dbaudin1/Kicad_Libraries_Perso/3D/IDEFX/Body.step

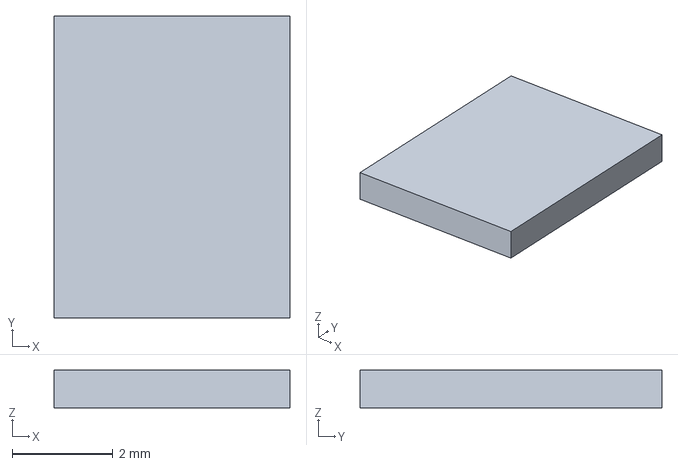
[picture p1: CAD file, 2022-09-28]
3D/IDEFX/Body.step
4.68 x 6.00 x 0.75 mm
