dbaudin1/Kicad_Libraries_Perso/3D/SDD/Body.step

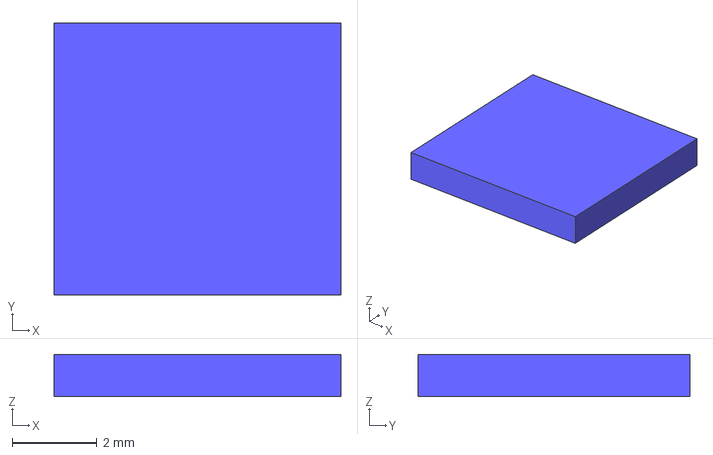
[picture p2: CAD file, 2022-09-28]
3D/SDD/Body.step
6.78 x 6.43 x 1.00 mm
