dbaudin1/Kicad_Libraries_Perso/3D/CLP-109-02-F-DH.stp

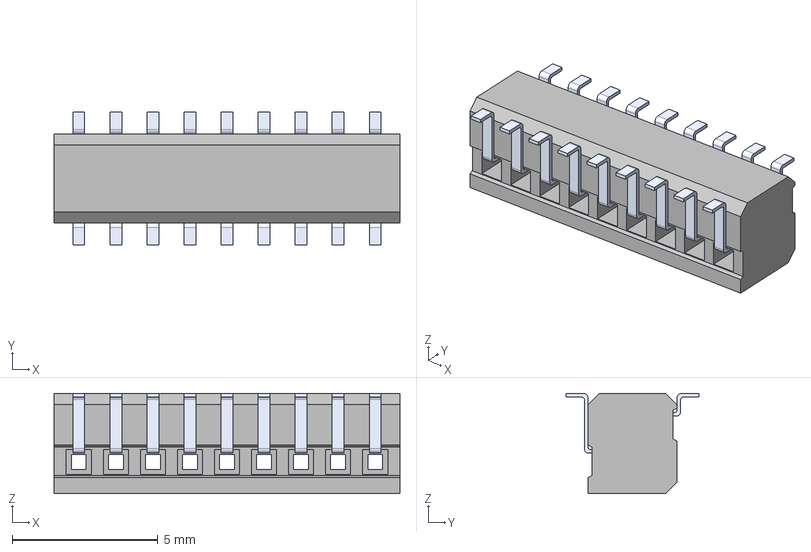
[picture p3: CAD file, 2024-11-20]
3D/CLP-109-02-F-DH.stp
11.9 x 4.57 x 3.43 mm
C-70-05-109_Pin_dh
C-70-04-109_Pin_2_dh
CLP-109-2-F-DH_terminal
