dbaudin1/Kicad_Libraries_Perso/3D/IDEFX/IDEFX.FCStd

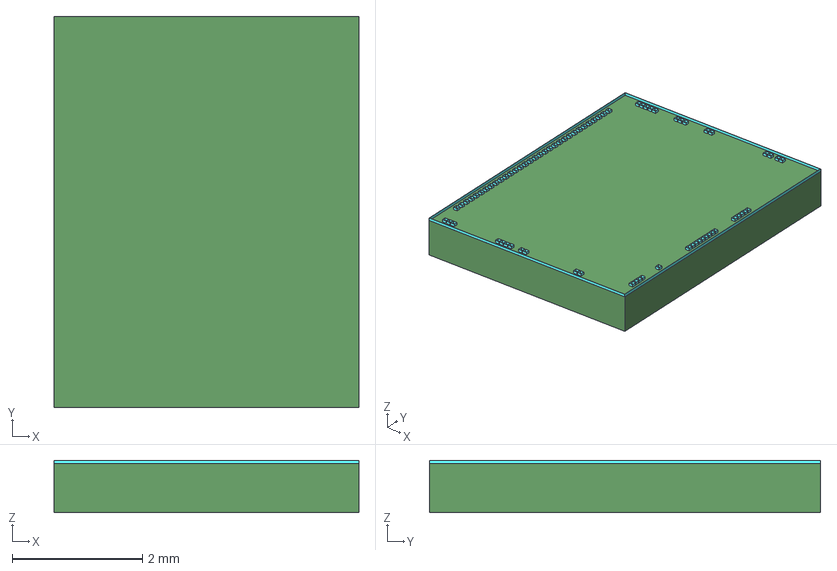
[picture p4: CAD file, 2022-09-28]
3D/IDEFX/IDEFX.FCStd
4.68 x 6.00 x 0.8 mm
