dbaudin1/Kicad_Libraries_Perso/3D/IDEFX/Extrude.step

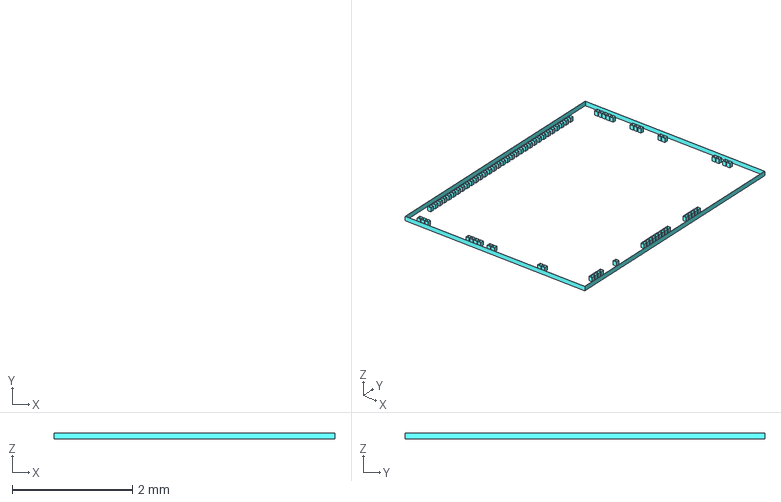
[picture p5: CAD file, 2022-09-28]
3D/IDEFX/Extrude.step
4.68 x 6.00 x 0.1 mm
