dbaudin1/Kicad_Libraries_Perso/3D/Fischer_DBPE_105_A069-130.stp

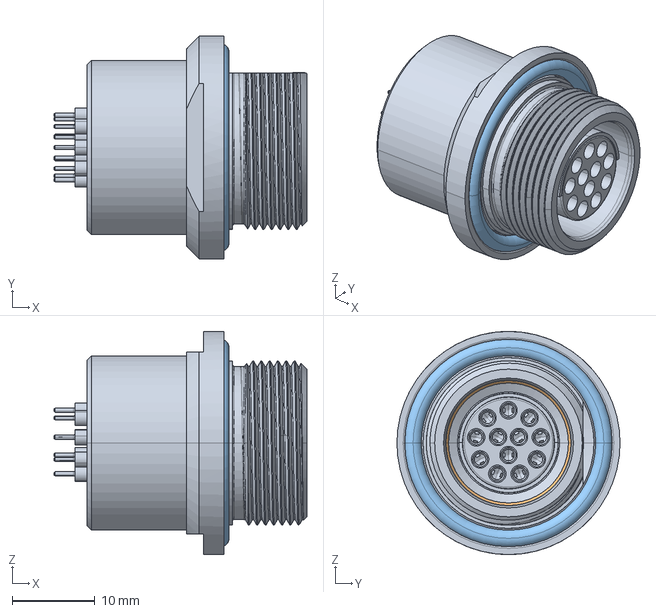
[picture p6: CAD file, 2024-11-20]
3D/Fischer_DBPE_105_A069-130.stp
30.5 x 26.9 x 26.9 mm
