dbaudin1/Kicad_Libraries_Perso/3D/IND_IHLP-4040DZ_VIS.step

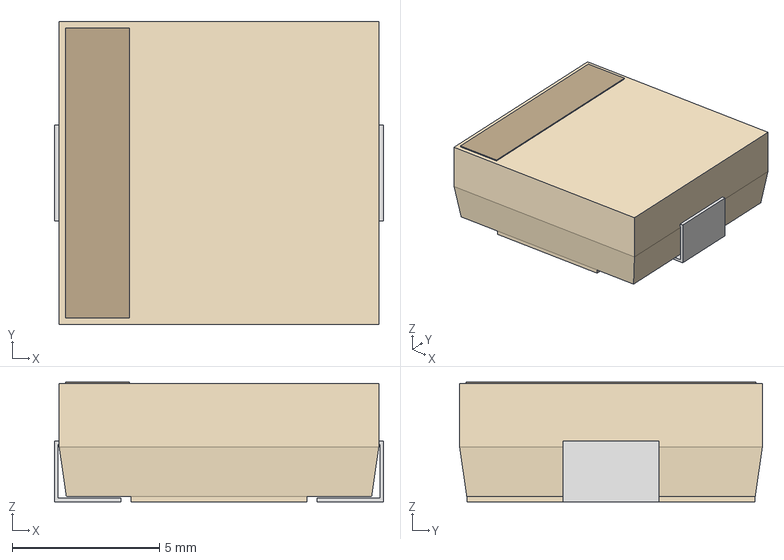
[picture p7: CAD file, 2024-11-20]
3D/IND_IHLP-4040DZ_VIS.step
11.2 x 10.3 x 4.06 mm
