dbaudin1/Kicad_Libraries_Perso/3D/CLP-118-02-F-DH.stp

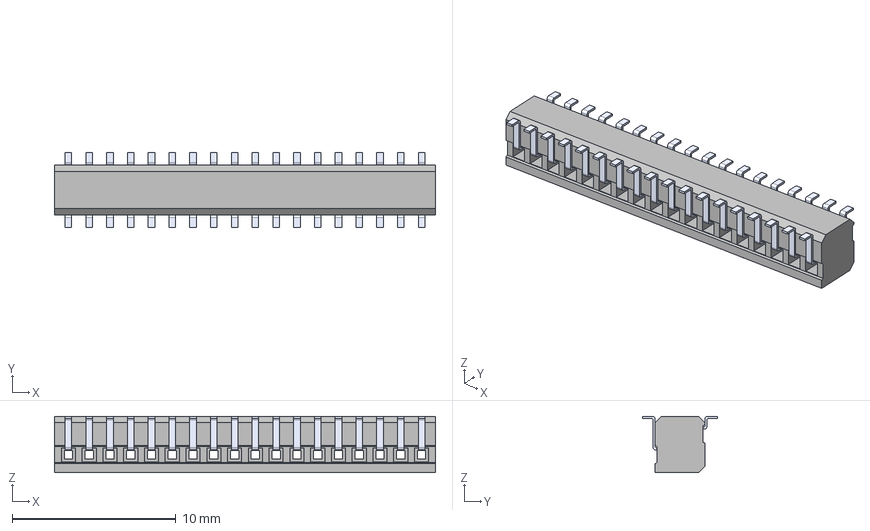
[picture p8: CAD file, 2024-11-20]
3D/CLP-118-02-F-DH.stp
23.3 x 4.57 x 3.43 mm
C-70-05-118_Pin_dh
C-70-04-118_Pin_2_dh
CLP-118-2-F-DH_terminal
