dbaudin1/Kicad_Libraries_Perso/3D/mill-max-0921-5-15-20-77-14-11-0.step

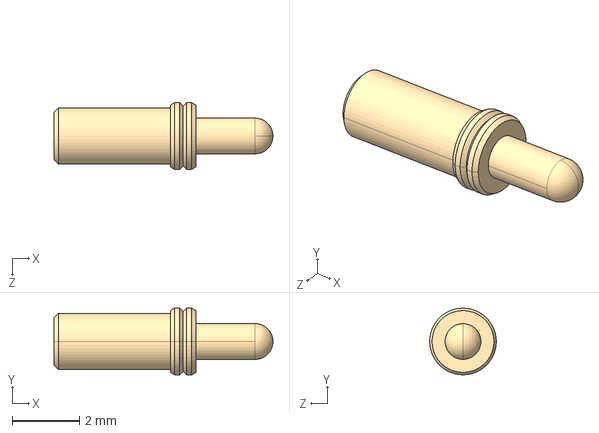
[picture p9: CAD file, 2024-11-20]
3D/mill-max-0921-5-15-20-77-14-11-0.step
6.50 x 1.98 x 1.98 mm
