dbaudin1/Kicad_Libraries_Perso/3D/ezg_00_302_cln.stp

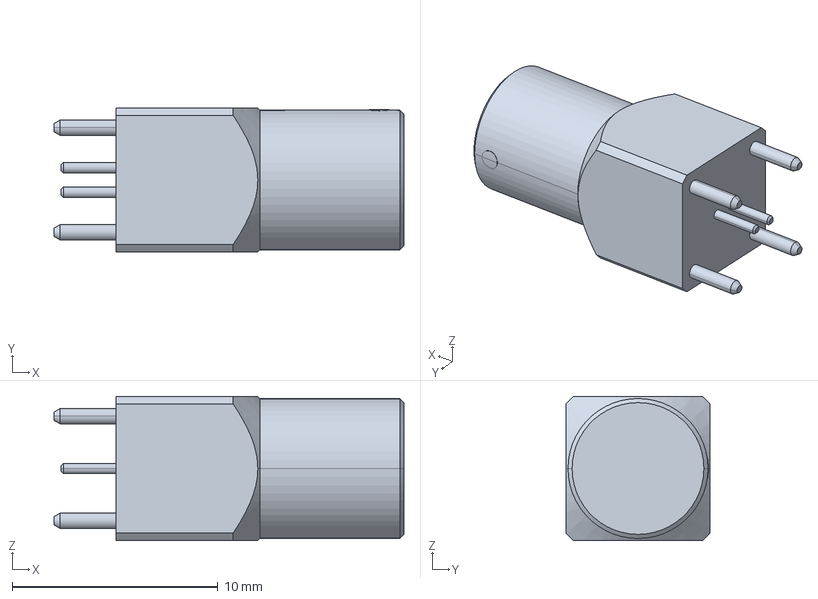
[picture p10: CAD file, 2024-11-20]
3D/ezg_00_302_cln.stp
17.0 x 7.00 x 7.00 mm
