dbaudin1/Kicad_Libraries_Perso/3D/901-144.stp

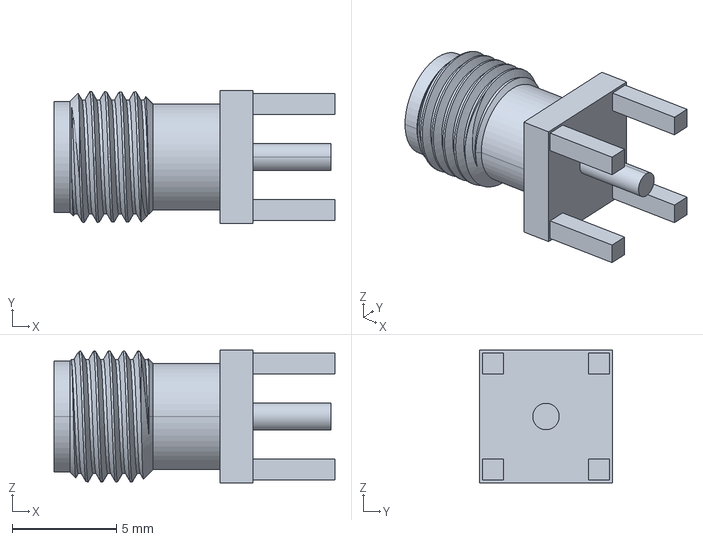
[picture p11: CAD file, 2024-11-20]
3D/901-144.stp
13.5 x 6.35 x 6.35 mm
