dbaudin1/Kicad_Libraries_Perso/3D/OWB1_TOP.step

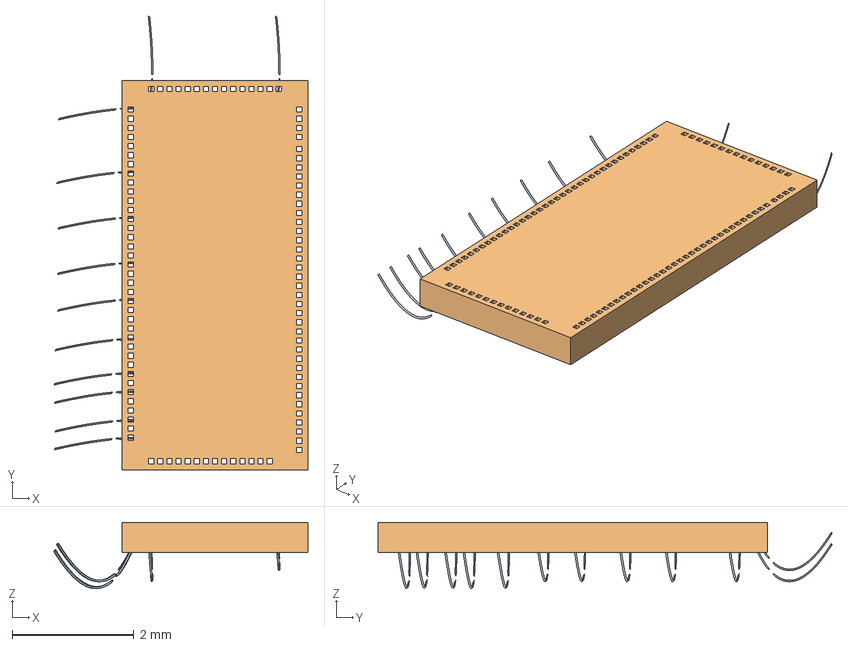
[picture p12: CAD file, 2024-11-20]
3D/OWB1_TOP.step
4.18 x 7.47 x 1.09 mm
