dbaudin1/Kicad_Libraries_Perso/3D/311-xx-102-41-001000.STEP

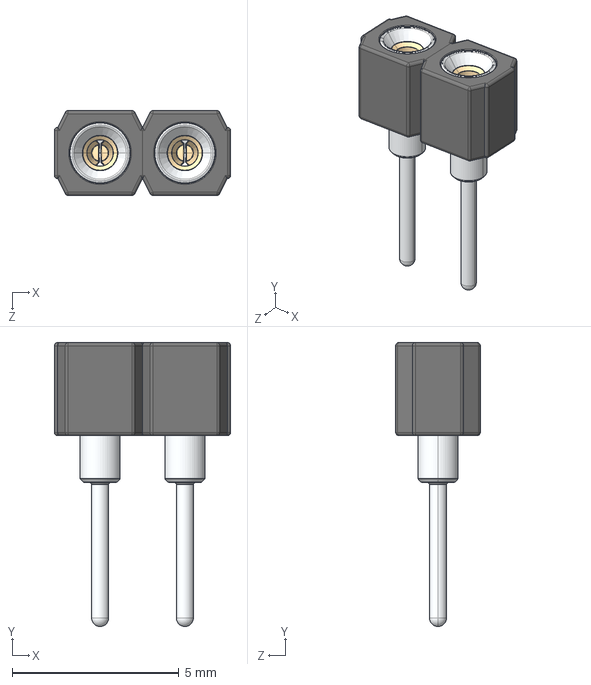
[picture p13: CAD file, 2024-11-20]
3D/311-xx-102-41-001000.STEP
5.28 x 8.51 x 2.54 mm
311-xx-101-41-001000 x 2
