dbaudin1/Kicad_Libraries_Perso/3D/SMA-J-P-H-ST-EM1.stp

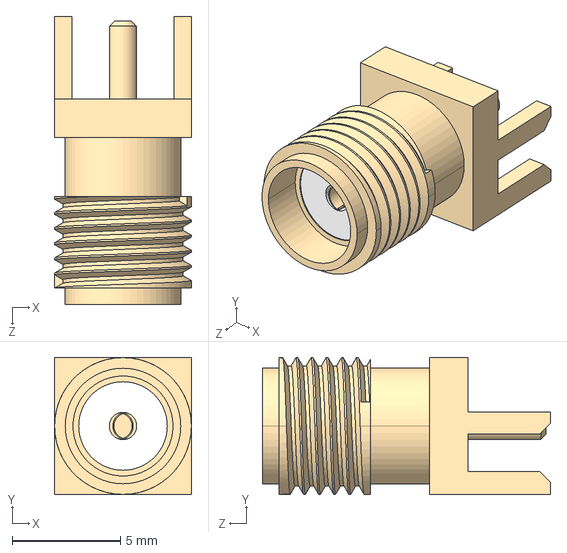
[picture p14: CAD file, 2024-11-20]
3D/SMA-J-P-H-ST-EM1.stp
6.35 x 6.35 x 13.3 mm
