dbaudin1/Kicad_Libraries_Perso/3D/DCCM37SCBRP.stp

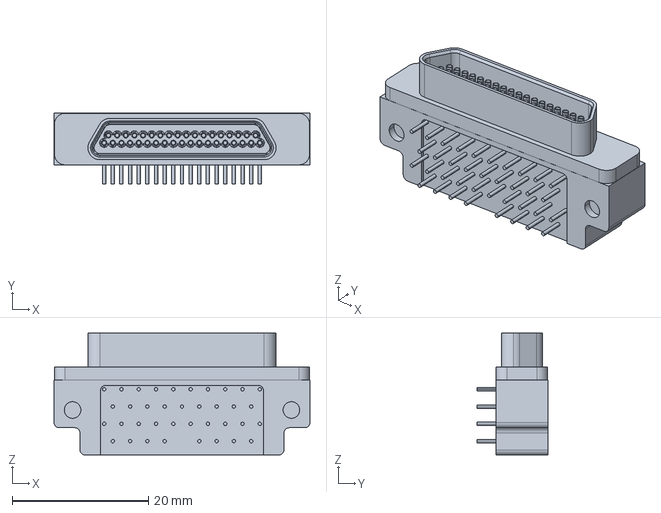
[picture p15: CAD file, 2022-09-28]
3D/DCCM37SCBRP.stp
37.6 x 10.4 x 17.9 mm
