dbaudin1/Kicad_Libraries_Perso/3D/IDC_RightAngle_02x03.stp

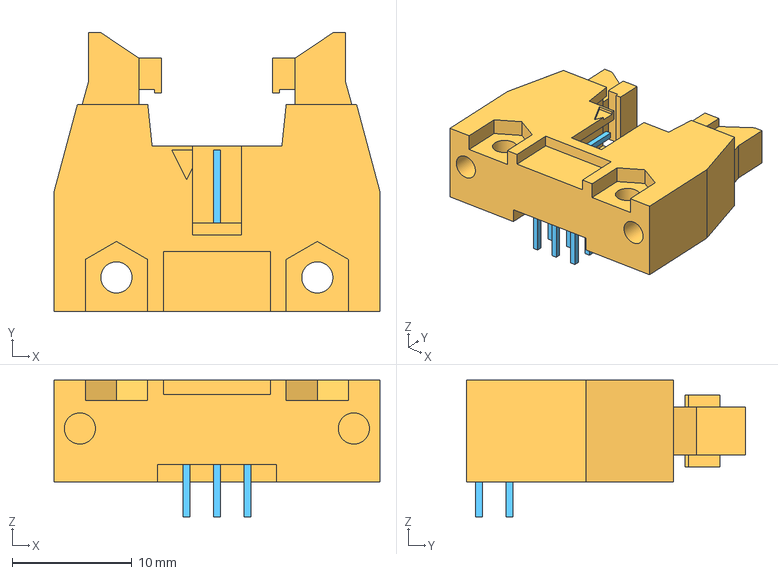
[picture p16: CAD file, 2022-09-28]
3D/IDC_RightAngle_02x03.stp
27.2 x 23.3 x 11.4 mm
