dbaudin1/Kicad_Libraries_Perso/3D/TF31-12S-0.5SH_3d_stp.stp

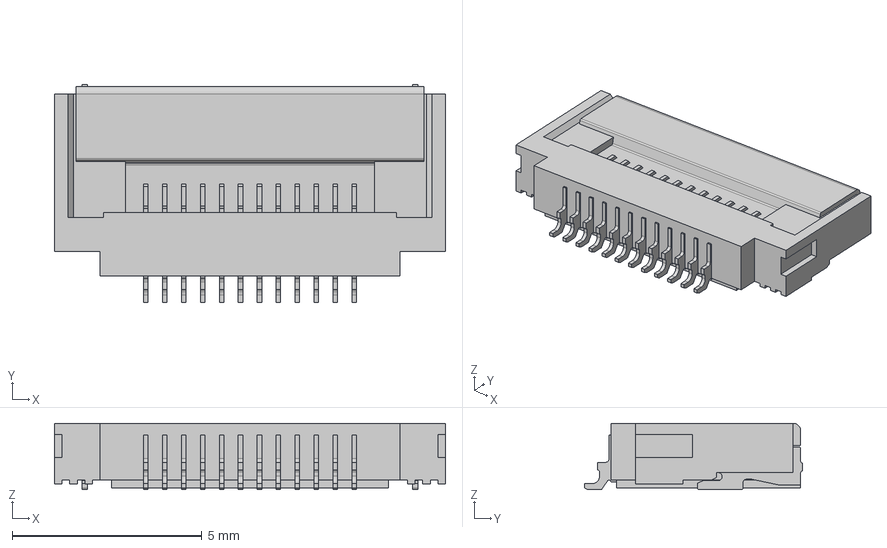
[picture p17: CAD file, 2022-09-28]
3D/TF31-12S-0.5SH_3d_stp.stp
10.3 x 5.75 x 1.75 mm
