dbaudin1/Kicad_Libraries_Perso/3D/banana_plug.STEP

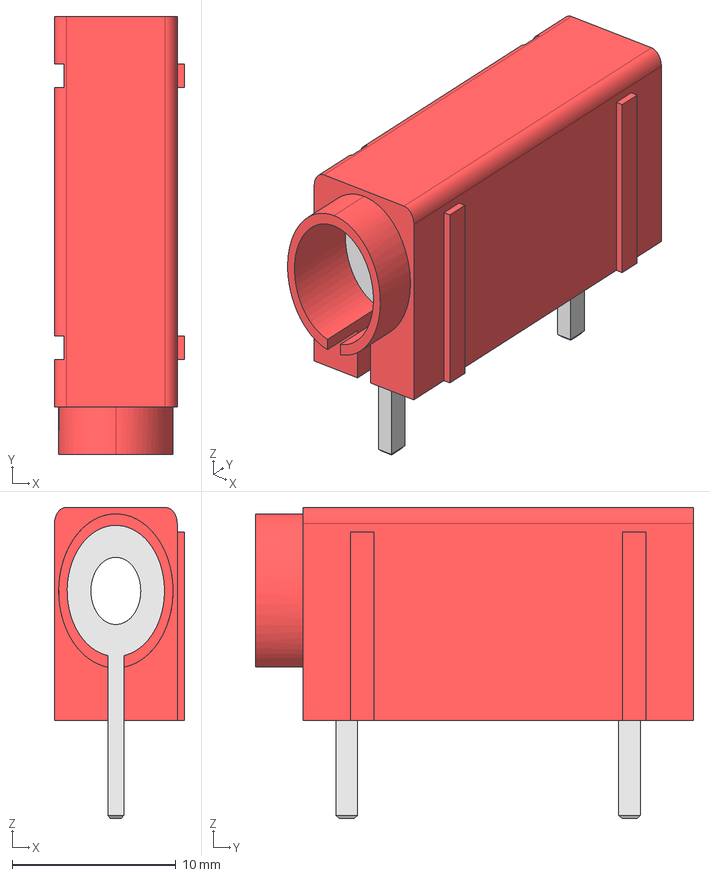
[picture p18: CAD file, 2022-09-28]
3D/banana_plug.STEP
7.95 x 26.7 x 19.0 mm
