dbaudin1/Kicad_Libraries_Perso/3D/s0921-46.stp

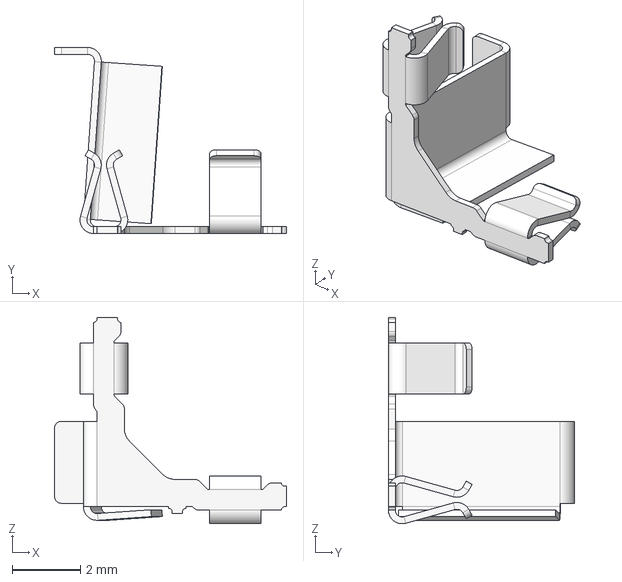
[picture p19: CAD file, 2022-09-28]
3D/s0921-46.stp
6.80 x 5.45 x 6.05 mm
