dbaudin1/Kicad_Libraries_Perso/3D/SMA_Edge.stp

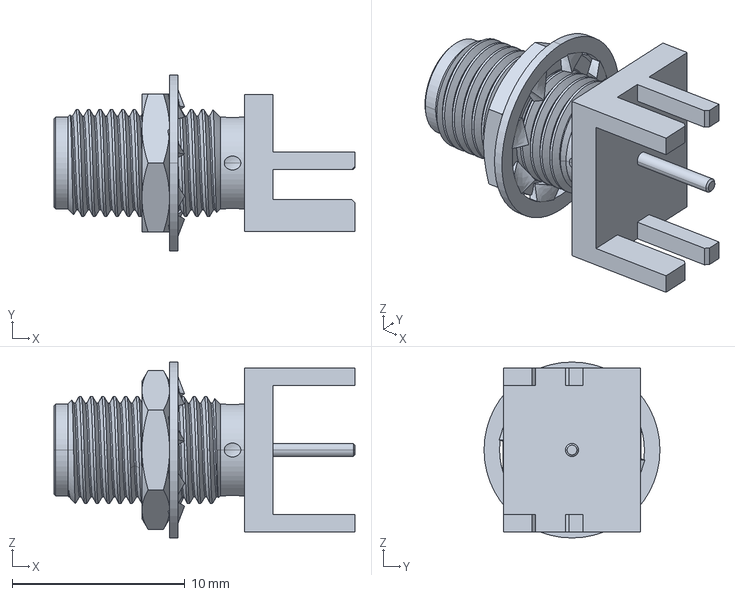
[picture p20: CAD file, 2022-09-28]
3D/SMA_Edge.stp
17.4 x 10.2 x 10.2 mm
