dbaudin1/Kicad_Libraries_Perso/3D/microD_25.stp

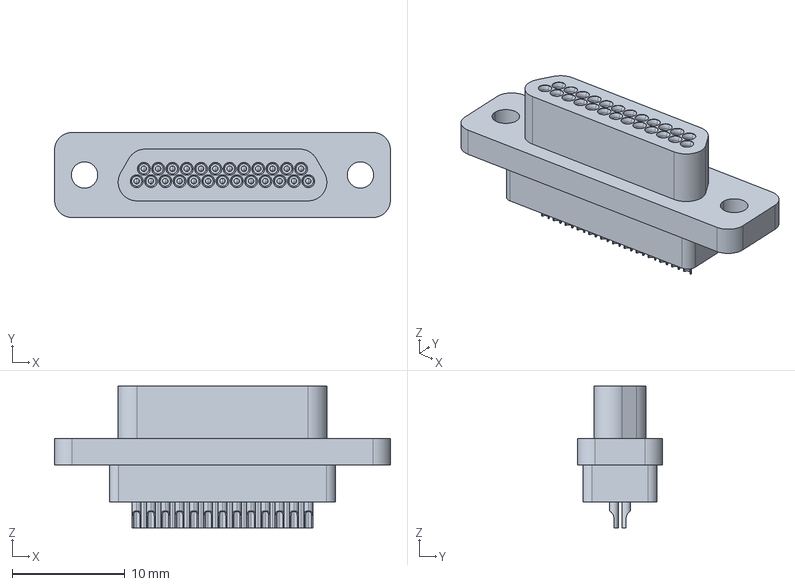
[picture p21: CAD file, 2022-09-28]
3D/microD_25.stp
29.8 x 7.57 x 12.6 mm
