dbaudin1/Kicad_Libraries_Perso/3D/s0911-46.stp

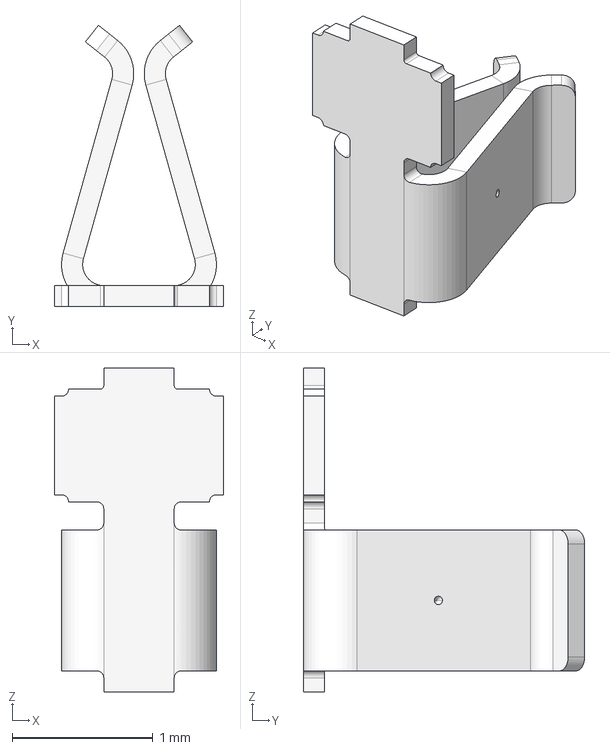
[picture p23: CAD file, 2022-09-28]
3D/s0911-46.stp
1.20 x 2.00 x 2.30 mm
