dbaudin1/Kicad_Libraries_Perso/3D/IDC_RA_02x02.stp

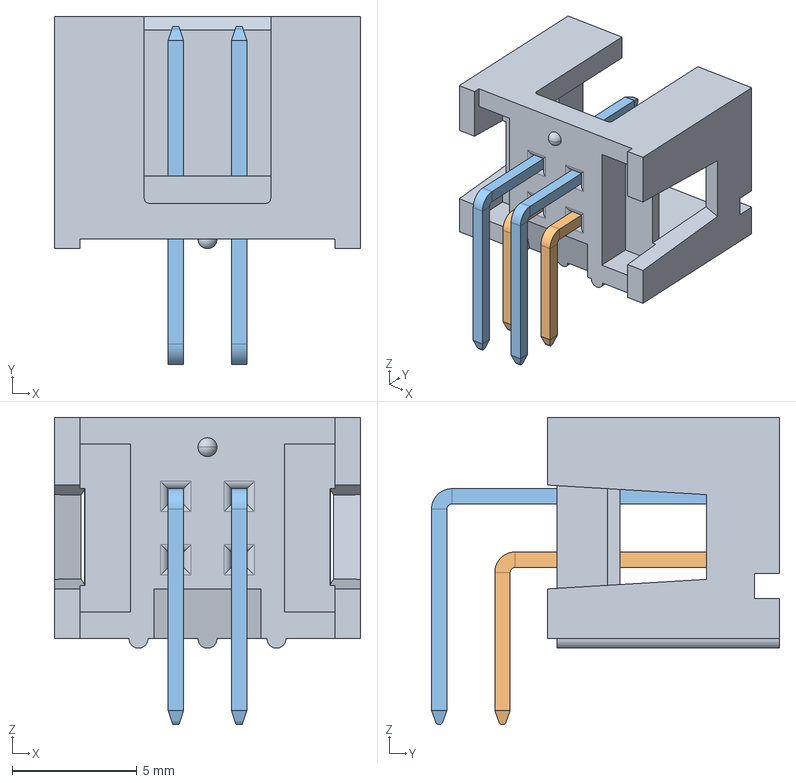
[picture p24: CAD file, 2022-09-28]
3D/IDC_RA_02x02.stp
12.3 x 14.0 x 12.3 mm
71965_Y04
71953_X03 x 2
71953_X04 x 2
