dbaudin1/Kicad_Libraries_Perso/3D/DCCM37PCBRP.stp

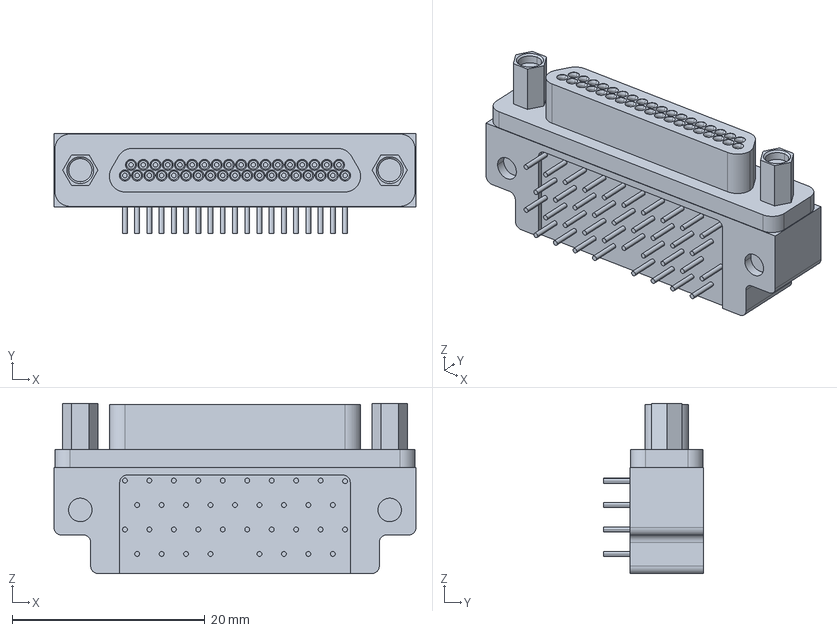
[picture p25: CAD file, 2022-09-28]
3D/DCCM37PCBRP.stp
37.6 x 10.4 x 17.7 mm
