dbaudin1/Kicad_Libraries_Perso/3D/Switch_090320102.stp

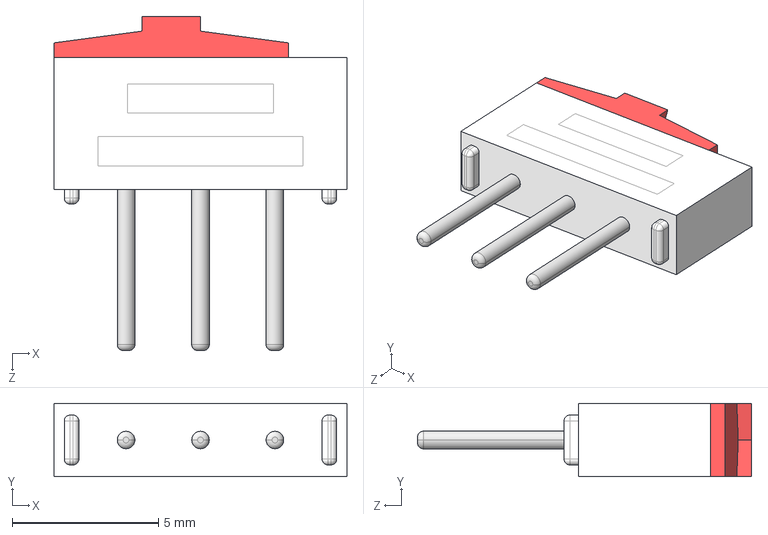
[picture p26: CAD file, 2022-09-28]
3D/Switch_090320102.stp
10.0 x 2.50 x 11.4 mm
