dbaudin1/Kicad_Libraries_Perso/3D/SMA_RA_SurfaceMount.stp

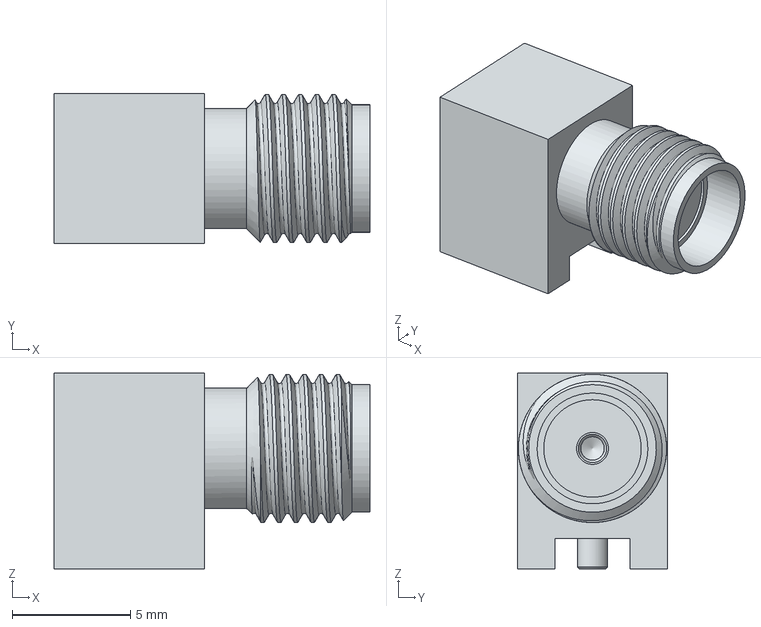
[picture p27: CAD file, 2021-06-25]
3D/SMA_RA_SurfaceMount.stp
13.3 x 6.35 x 8.26 mm
