dbaudin1/Kicad_Libraries_Perso/3D/Toogle_Switch.stp

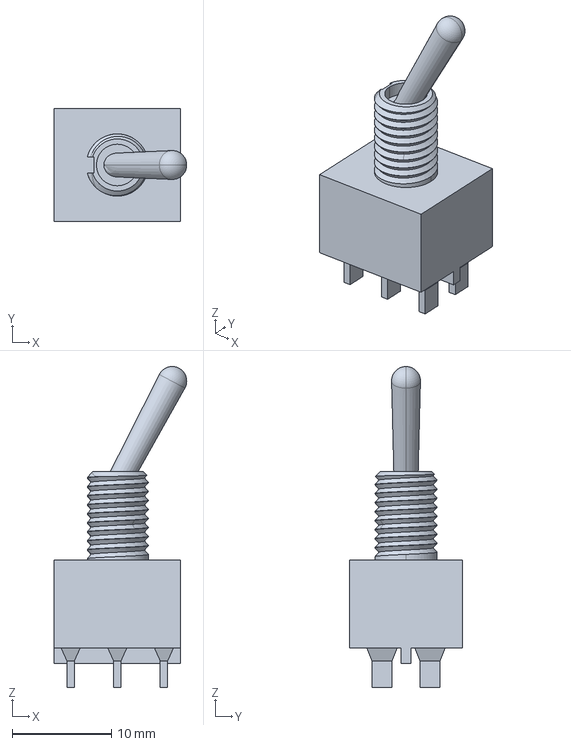
[picture p28: CAD file, 2021-06-25]
3D/Toogle_Switch.stp
13.3 x 11.4 x 32.3 mm
