dbaudin1/Kicad_Libraries_Perso/3D/c-282834-3-c-3d.stp

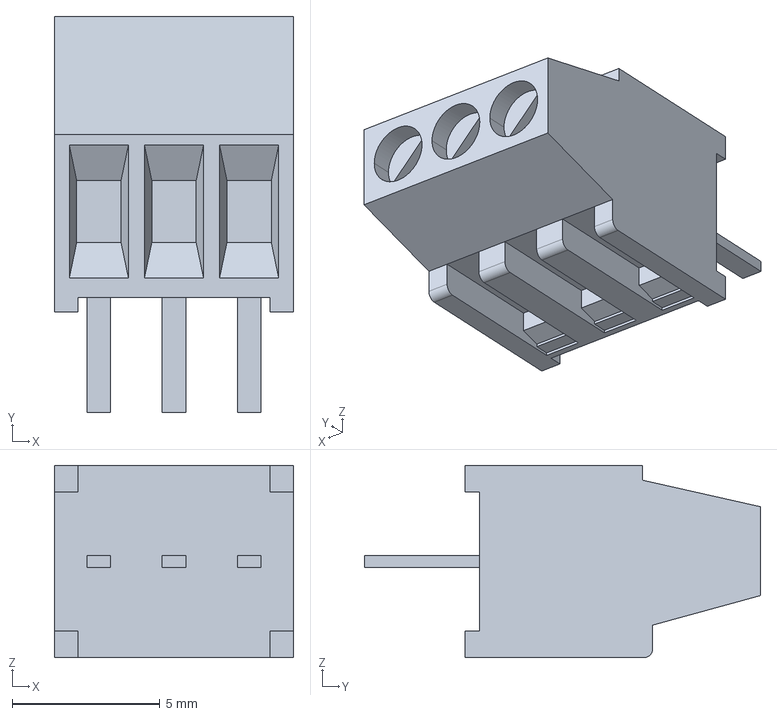
[picture p29: CAD file, 2021-04-16]
3D/c-282834-3-c-3d.stp
8.08 x 13.4 x 6.50 mm
