dbaudin1/Kicad_Libraries_Perso/3D/LCC8_1P5X3P2_STM.step

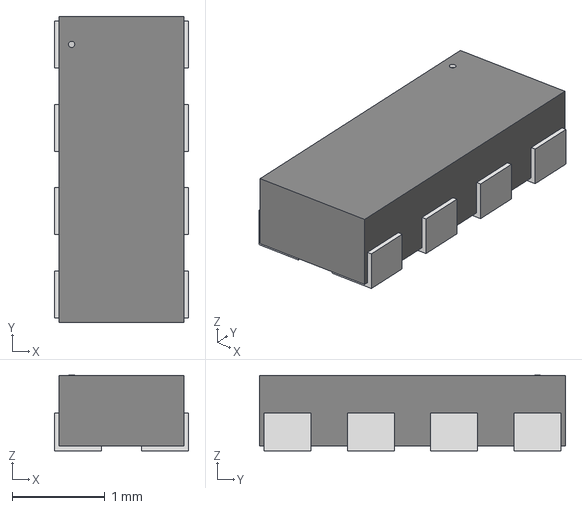
[picture p30: CAD file, 2021-04-16]
3D/LCC8_1P5X3P2_STM.step
1.45 x 3.30 x 0.815 mm
