dbaudin1/Kicad_Libraries_Perso/3D/QFN-44_MCH.step

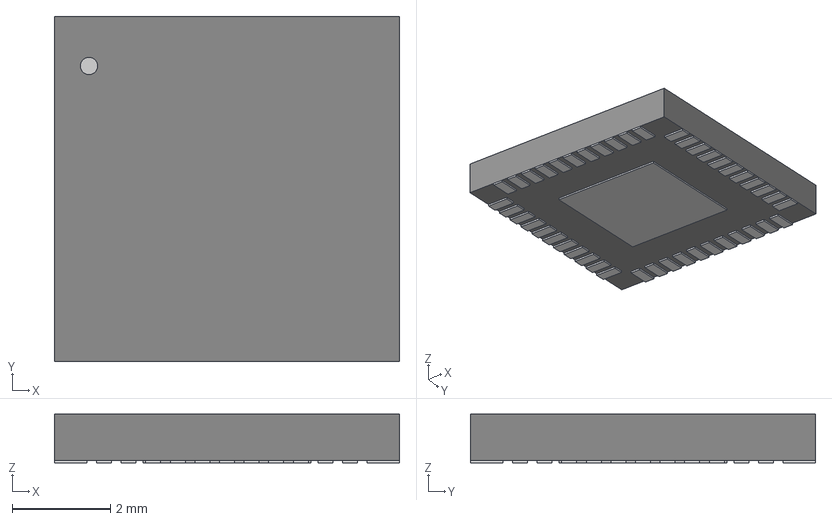
[picture p31: CAD file, 2021-04-16]
3D/QFN-44_MCH.step
7.01 x 7.01 x 0.993 mm
