dbaudin1/Kicad_Libraries_Perso/3D/RE_24_ADI.step

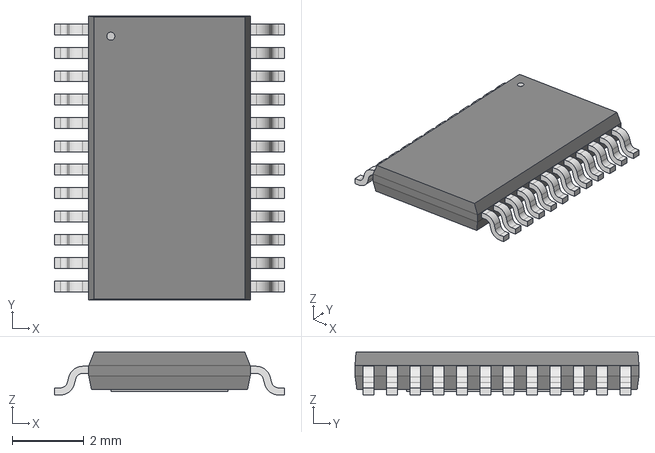
[picture p32: CAD file, 2021-04-16]
3D/RE_24_ADI.step
6.40 x 7.90 x 1.20 mm
