dbaudin1/Kicad_Libraries_Perso/3D/EPL.00.250.DTN.stp

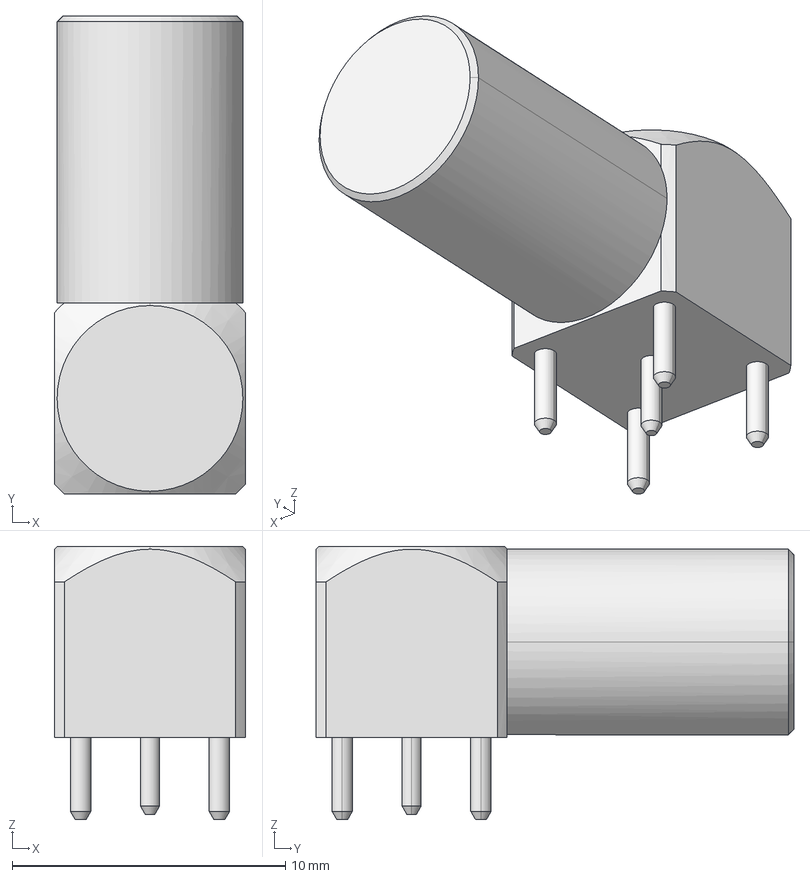
[picture p33: CAD file, 2021-04-16]
3D/EPL.00.250.DTN.stp
7.00 x 17.5 x 10.0 mm
