dbaudin1/Kicad_Libraries_Perso/3D/UM030Z1009JE.step

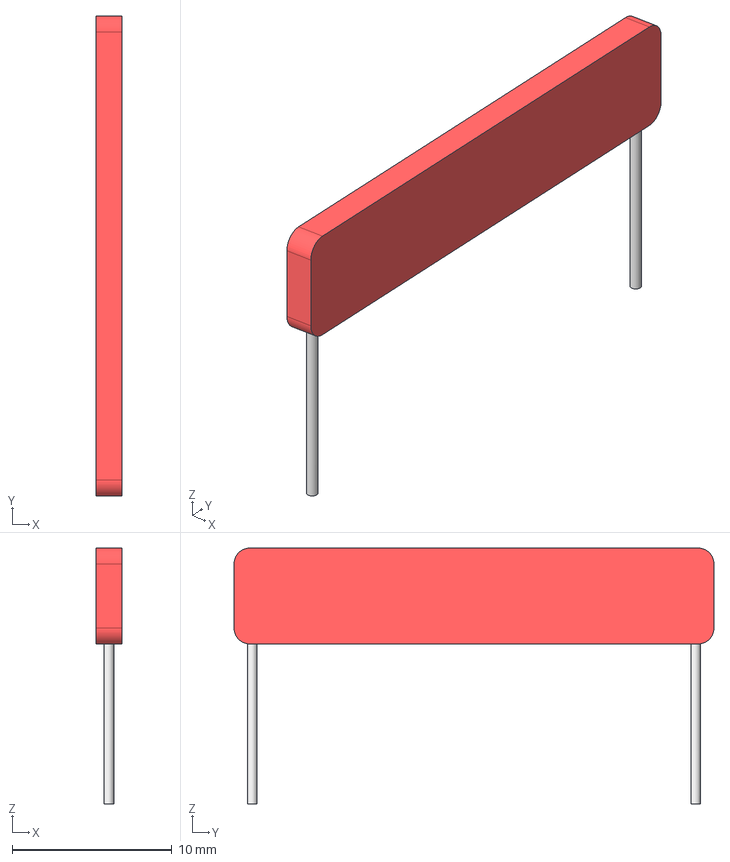
[picture p34: CAD file, 2021-04-16]
3D/UM030Z1009JE.step
1.60 x 30.0 x 16.0 mm
