dbaudin1/Kicad_Libraries_Perso/3D/RJ45_RA.STEP

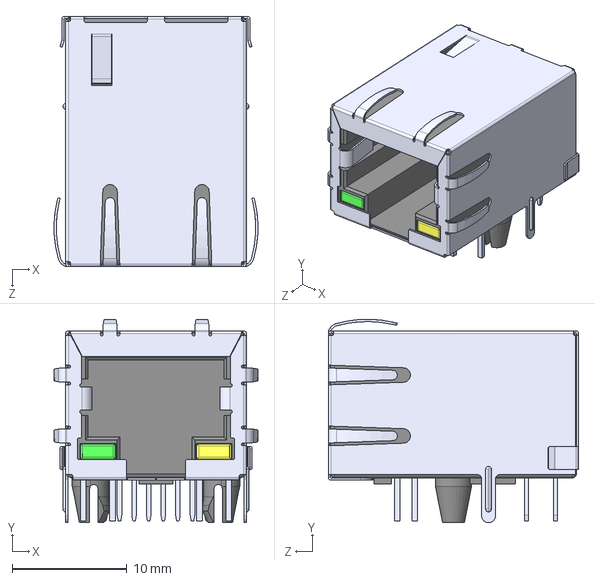
[picture p35: CAD file, 2021-04-16]
3D/RJ45_RA.STEP
17.7 x 17.7 x 21.8 mm
