dbaudin1/Kicad_Libraries_Perso/3D/3214w-1-100e.stp

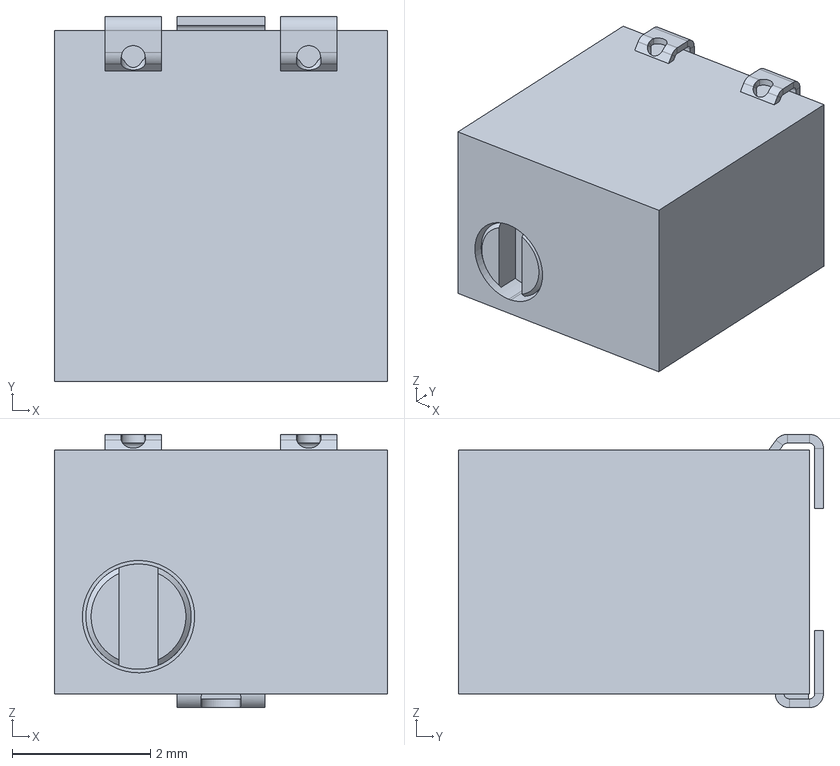
[picture p36: CAD file, 2021-04-16]
3D/3214w-1-100e.stp
4.83 x 5.28 x 3.96 mm
