dbaudin1/Kicad_Libraries_Perso/3D/IHLP4040DZ (2.2-100uH).STEP

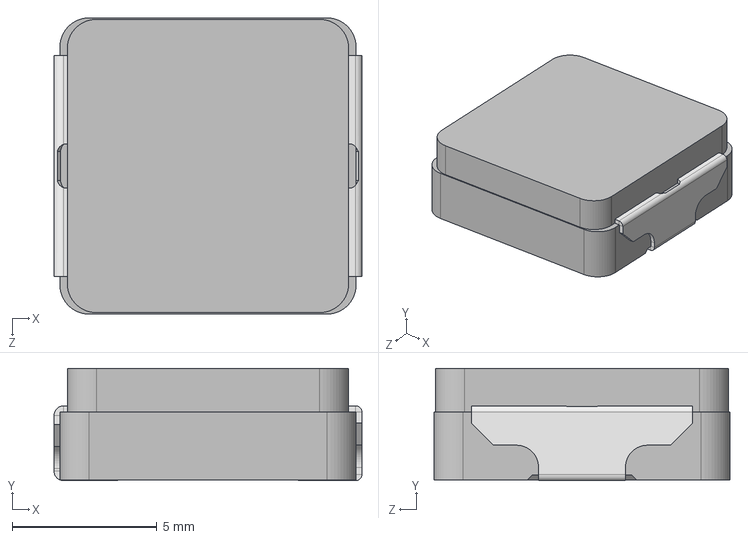
[picture p37: CAD file, 2021-04-16]
3D/IHLP4040DZ (2.2-100uH).STEP
10.6 x 3.87 x 10.2 mm
