dbaudin1/Kicad_Libraries_Perso/3D/c-2267078-9-a-3d.stp

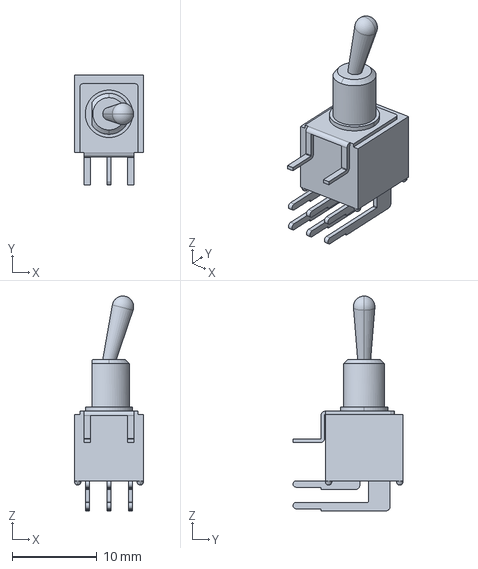
[picture p38: CAD file, 2021-04-16]
3D/c-2267078-9-a-3d.stp
8.13 x 13.0 x 25.3 mm
