dbaudin1/Kicad_Libraries_Perso/3D/Tact Switch SMD 4.5x4.5mm.stp

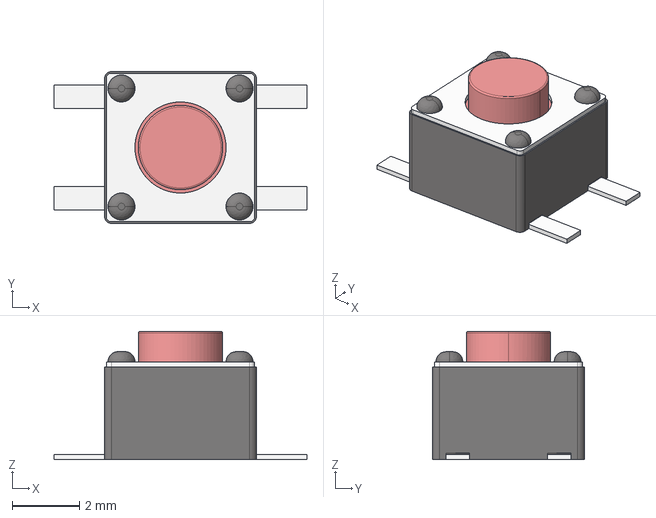
[picture p39: CAD file, 2021-04-16]
3D/Tact Switch SMD 4.5x4.5mm.stp
7.50 x 4.50 x 3.80 mm
