dbaudin1/Kicad_Libraries_Perso/3D/BNC_Straight.stp

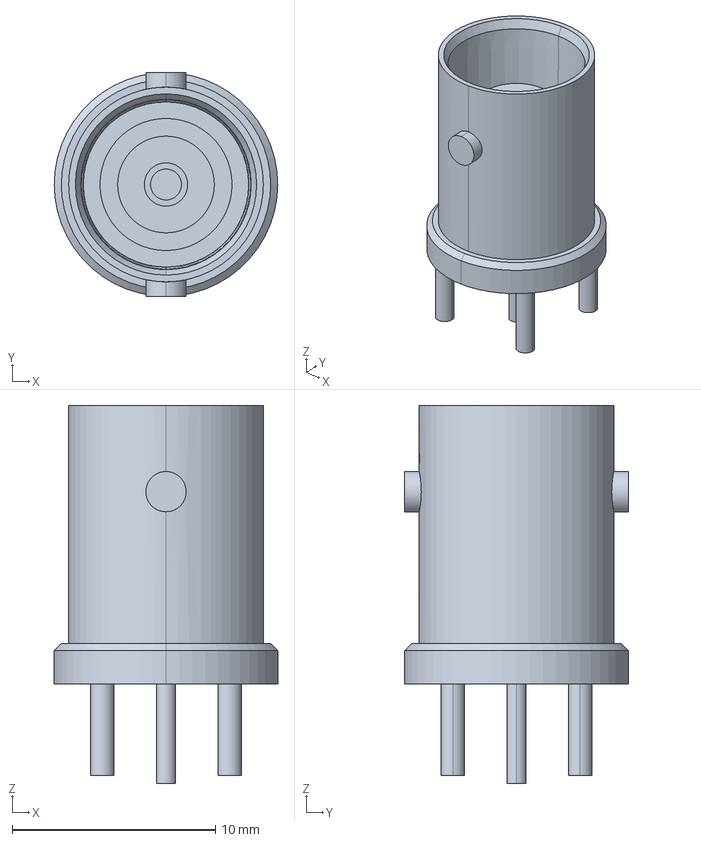
[picture p40: CAD file, 2021-04-16]
3D/BNC_Straight.stp
11.0 x 11.0 x 18.6 mm
