dbaudin1/Kicad_Libraries_Perso/3D/ST_64_2_ADI.step

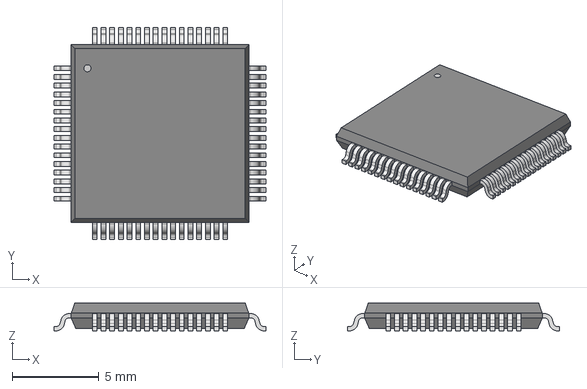
[picture p41: CAD file, 2021-04-16]
3D/ST_64_2_ADI.step
12.2 x 12.2 x 1.60 mm
