dbaudin1/Kicad_Libraries_Perso/3D/MicroD_9_RA.stp

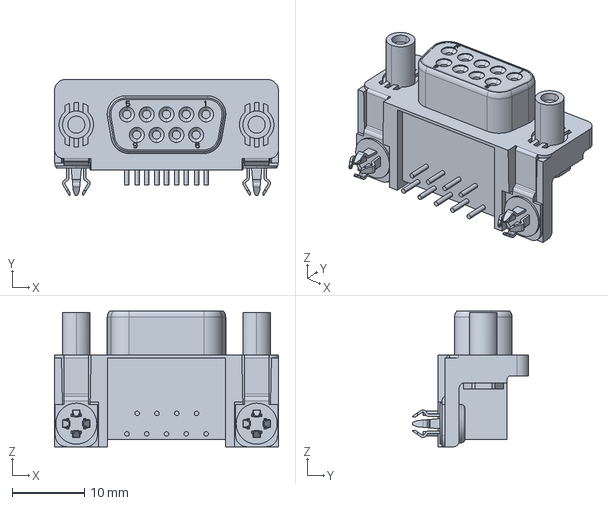
[picture p42: CAD file, 2021-04-16]
3D/MicroD_9_RA.stp
31.0 x 16.1 x 18.8 mm
