dbaudin1/Kicad_Libraries_Perso/3D/DF12NB-20DS-0.5V.stp

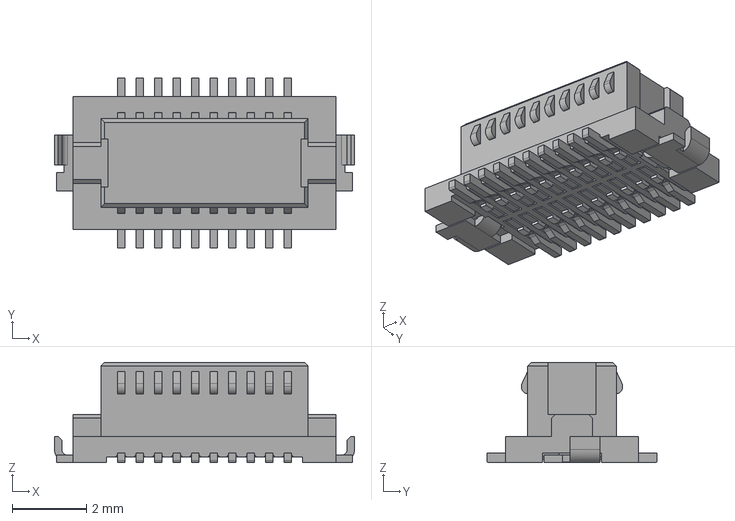
[picture p43: CAD file, 2021-04-16]
3D/DF12NB-20DS-0.5V.stp
8.10 x 4.60 x 2.70 mm
