dbaudin1/Kicad_Libraries_Perso/3D/c-1462037-4-a7-3d.stp

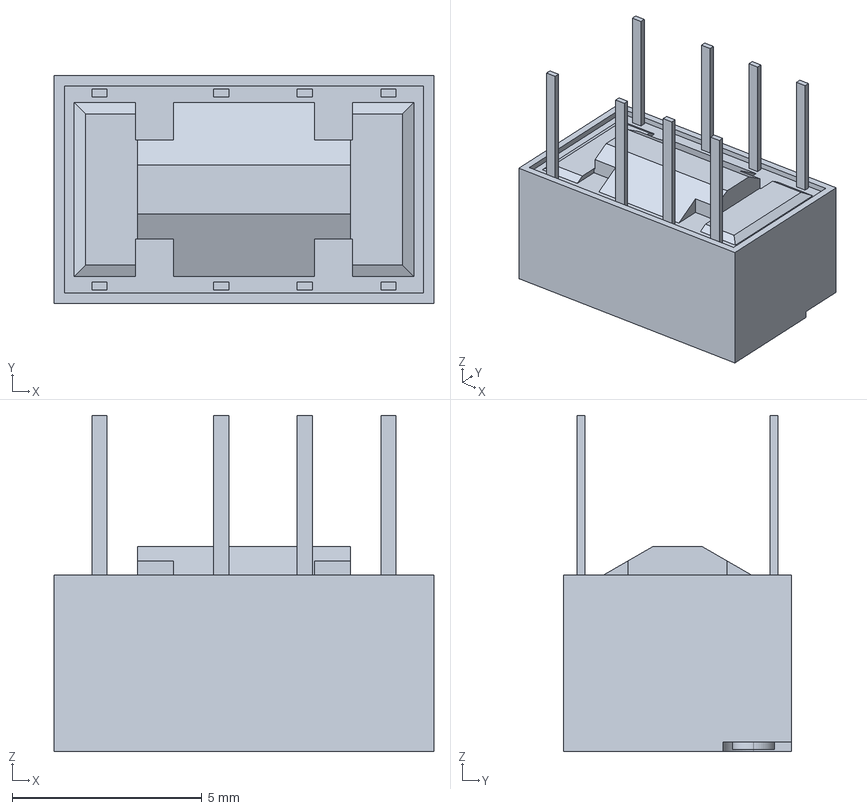
[picture p44: CAD file, 2021-04-16]
3D/c-1462037-4-a7-3d.stp
10.0 x 6.00 x 8.85 mm
