dbaudin1/Kicad_Libraries_Perso/3D/RU_16_ADI.step

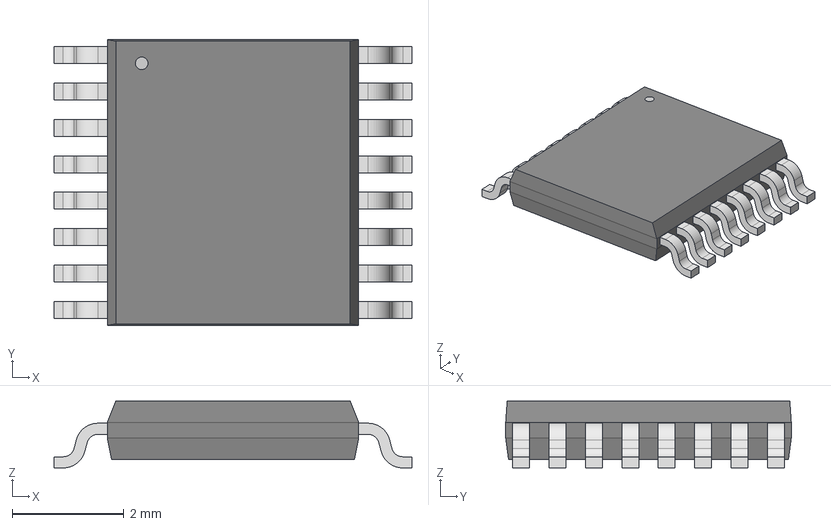
[picture p46: CAD file, 2021-04-16]
3D/RU_16_ADI.step
6.40 x 5.11 x 1.20 mm
