dbaudin1/Kicad_Libraries_Perso/3D/RU_14_ADI.step

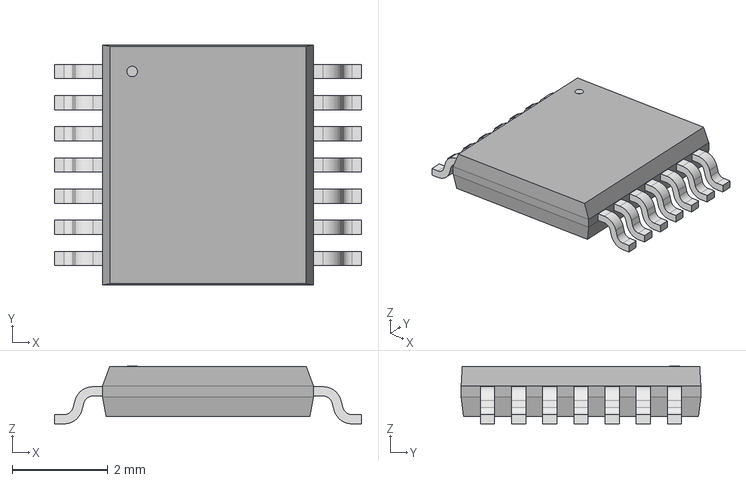
[picture p47: CAD file, 2021-04-16]
3D/RU_14_ADI.step
6.40 x 5.00 x 1.20 mm
