dbaudin1/Kicad_Libraries_Perso/3D/so8-3.step

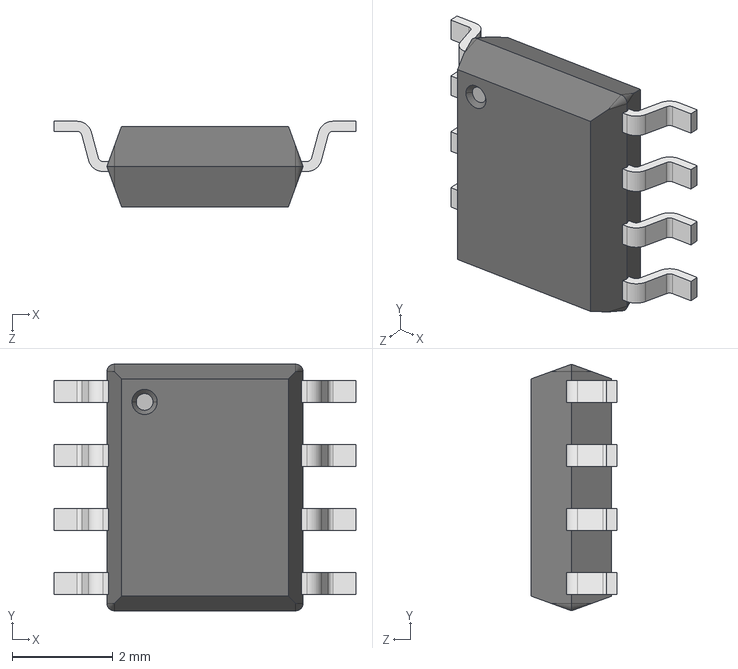
[picture p48: CAD file, 2021-04-16]
3D/so8-3.step
6.00 x 4.90 x 1.70 mm
