dbaudin1/Kicad_Libraries_Perso/3D/CP_10_9_ADI.step

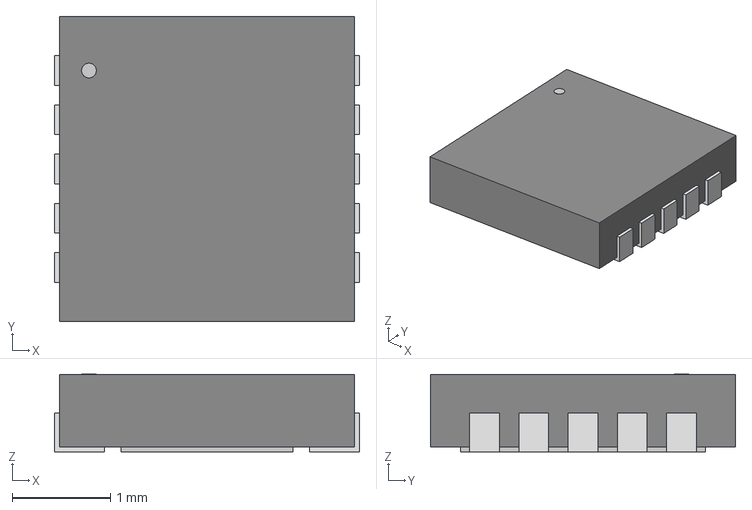
[picture p49: CAD file, 2021-04-16]
3D/CP_10_9_ADI.step
3.10 x 3.10 x 0.79 mm
