dbaudin1/Kicad_Libraries_Perso/3D/MicroD_37_S.stp

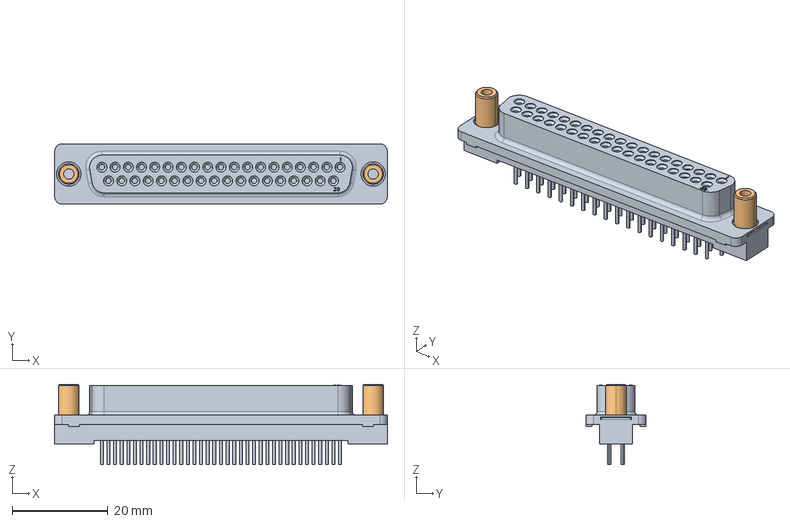
[picture p50: CAD file, 2021-04-16]
3D/MicroD_37_S.stp
69.5 x 12.6 x 16.8 mm
