dbaudin1/Kicad_Libraries_Perso/3D/User Library-LFCSP-24.STEP

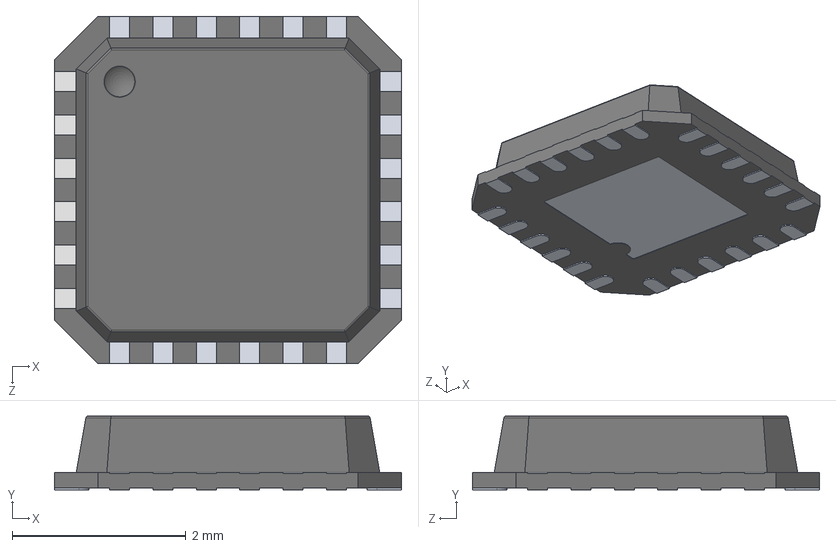
[picture p51: CAD file, 2021-04-16]
3D/User Library-LFCSP-24.STEP
4.00 x 0.85 x 4.00 mm
