dbaudin1/Kicad_Libraries_Perso/3D/Micron_-_MT25QL256ABA8ESF-0SIT.step

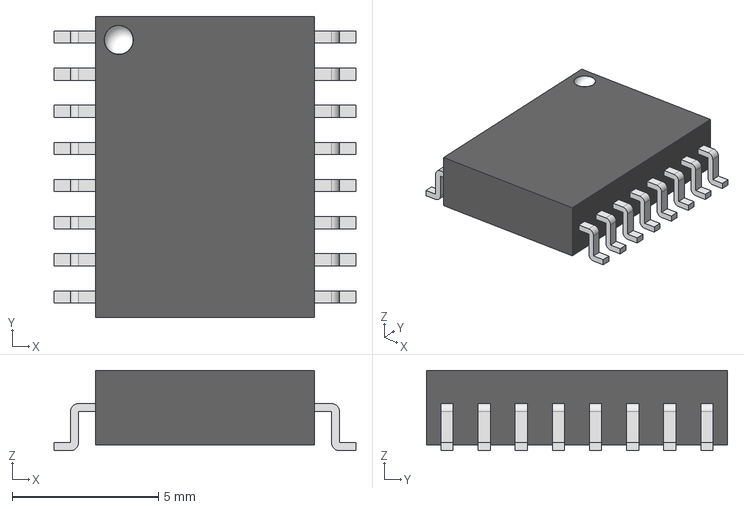
[picture p52: CAD file, 2021-04-16]
3D/Micron_-_MT25QL256ABA8ESF-0SIT.step
10.3 x 10.3 x 2.75 mm
