dbaudin1/Kicad_Libraries_Perso/3D/LT8365.step

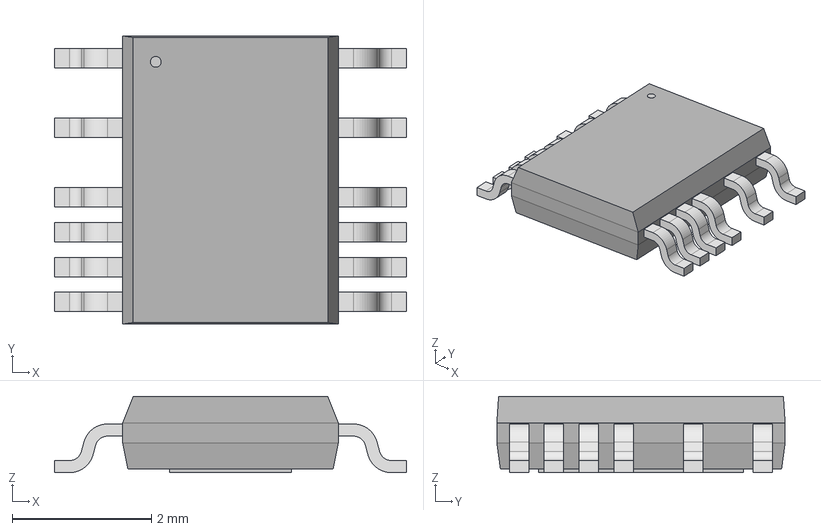
[picture p53: CAD file, 2021-04-16]
3D/LT8365.step
5.05 x 4.14 x 1.09 mm
