dbaudin1/Kicad_Libraries_Perso/3D/fx10a-168s-sv.stp

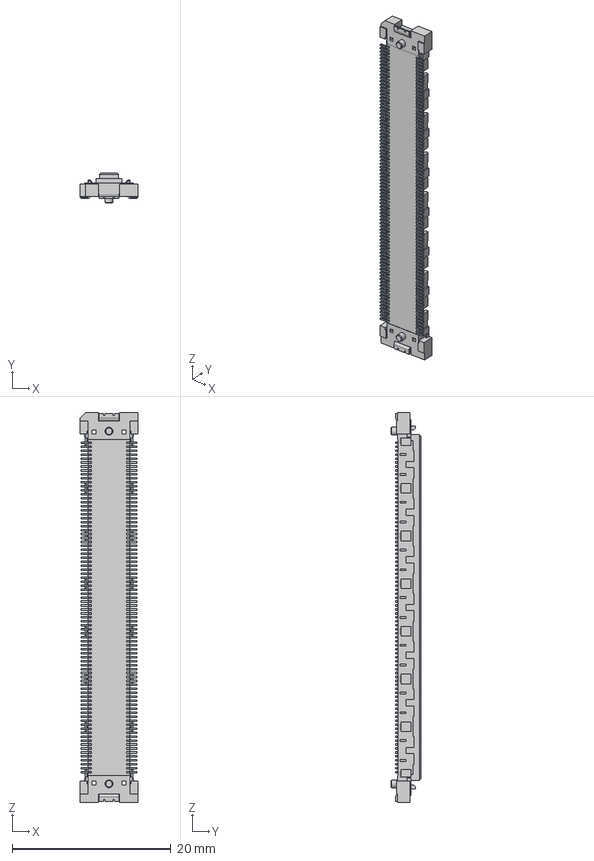
[picture p54: CAD file, 2021-04-16]
3D/fx10a-168s-sv.stp
7.30 x 3.80 x 49.1 mm
