dbaudin1/Kicad_Libraries_Perso/3D/MicroD_15_RA.stp

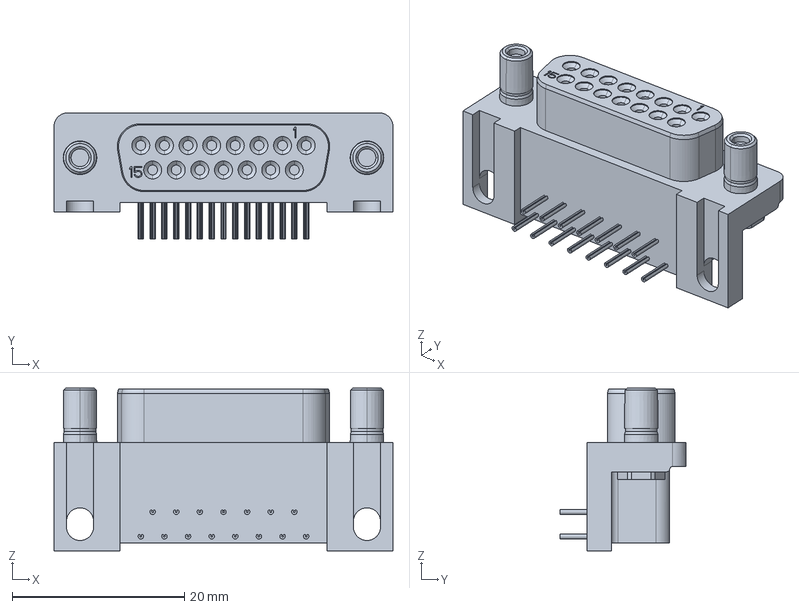
[picture p55: CAD file, 2021-04-16]
3D/MicroD_15_RA.stp
39.4 x 14.7 x 18.9 mm
