dbaudin1/Kicad_Libraries_Perso/3D/TPBGA24_5X5_MRN.step

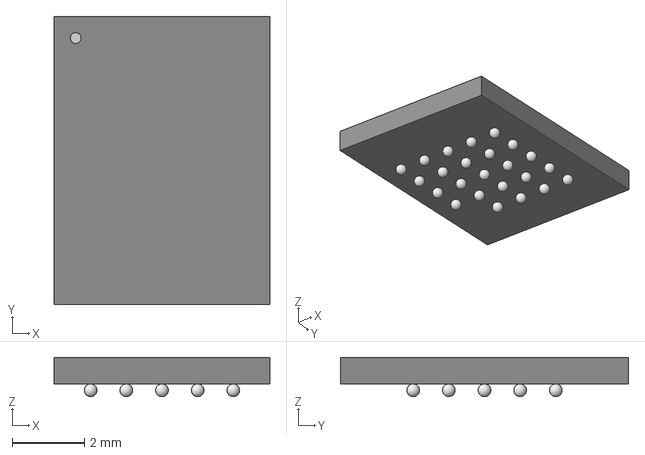
[picture p56: CAD file, 2021-04-16]
3D/TPBGA24_5X5_MRN.step
5.99 x 8.00 x 1.09 mm
