dbaudin1/Kicad_Libraries_Perso/3D/FBG676_XIL.step

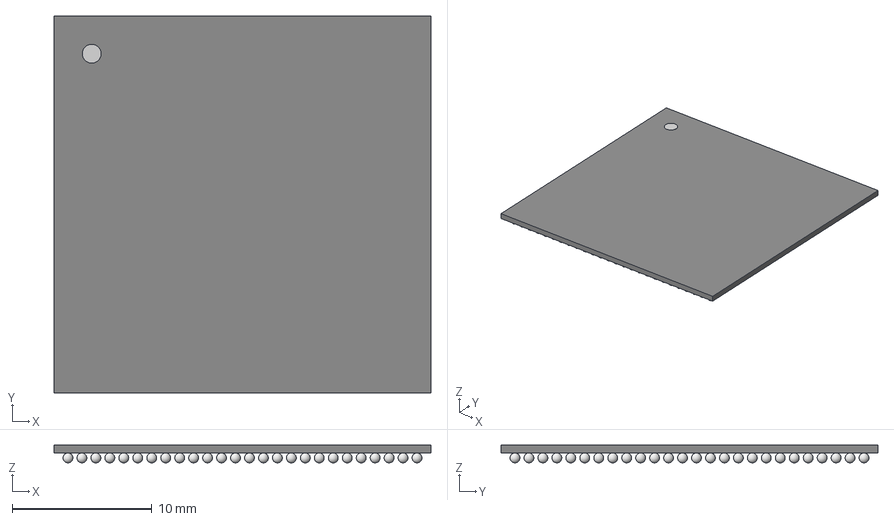
[picture p57: CAD file, 2021-04-16]
3D/FBG676_XIL.step
27.0 x 27.0 x 1.27 mm
