dbaudin1/Kicad_Libraries_Perso/3D/FX10A-140P14-SV.stp

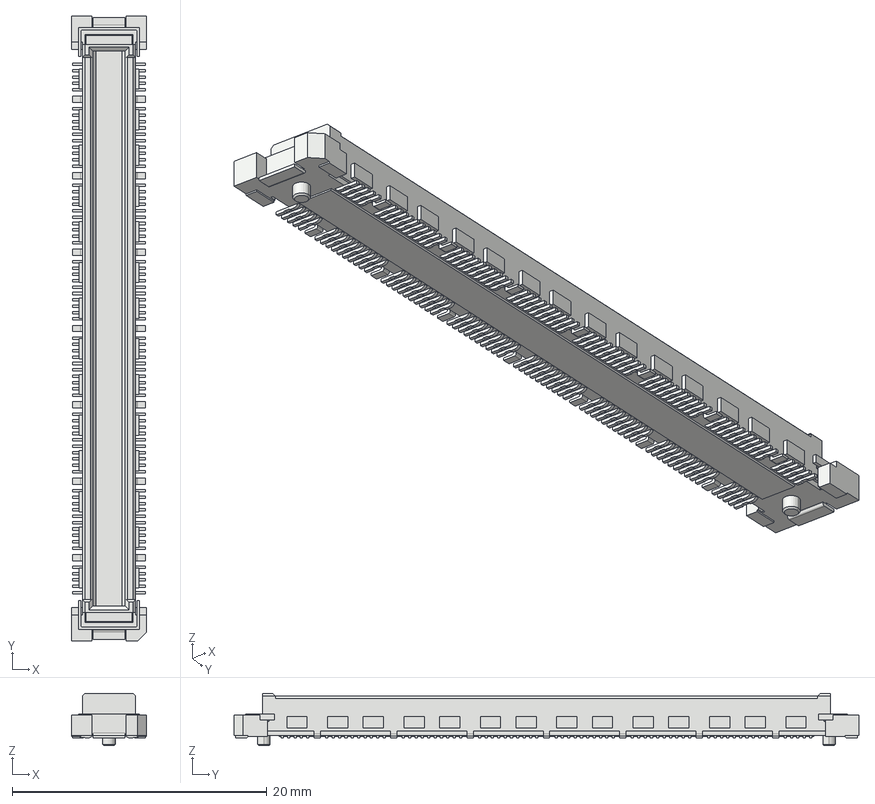
[picture p58: CAD file, 2021-04-16]
3D/FX10A-140P14-SV.stp
5.90 x 49.1 x 4.10 mm
