dbaudin1/Kicad_Libraries_Perso/3D/Push_Button_RightAngle.stp

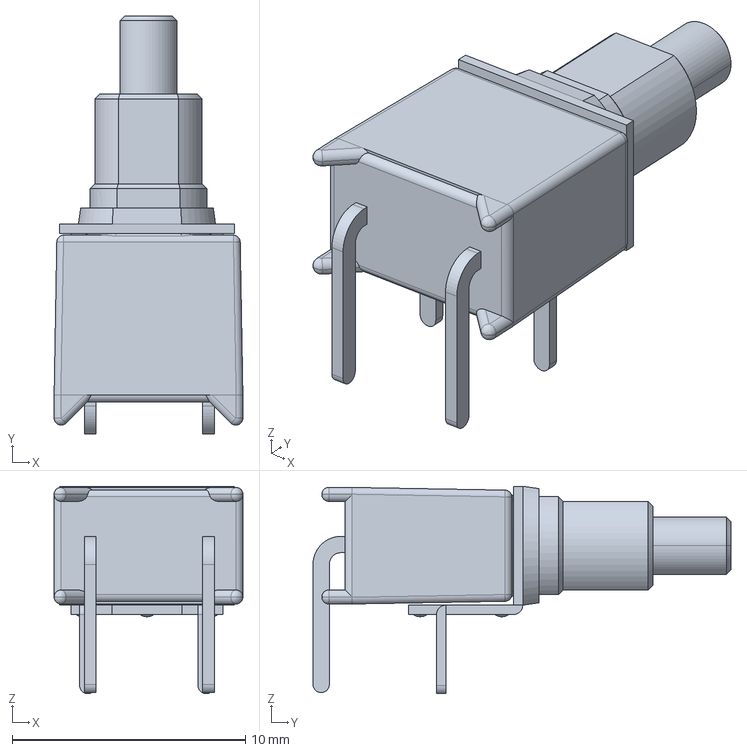
[picture p59: CAD file, 2021-04-16]
3D/Push_Button_RightAngle.stp
8.10 x 17.9 x 8.90 mm
