dbaudin1/Kicad_Libraries_Perso/3D/LED 3mm red housing.stp

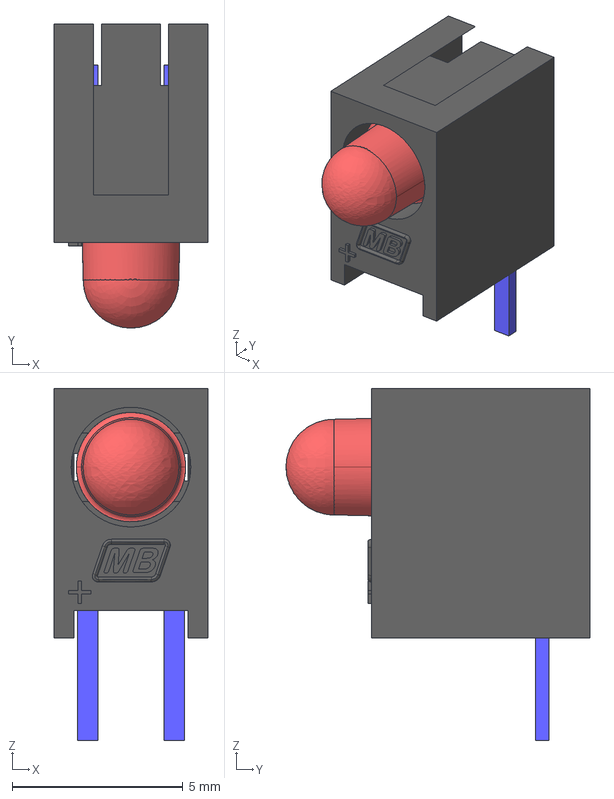
[picture p60: CAD file, 2021-04-16]
3D/LED 3mm red housing.stp
4.50 x 8.90 x 10.3 mm
