dbaudin1/Kicad_Libraries_Perso/3D/User Library-SMA_132134_Corrected.STEP

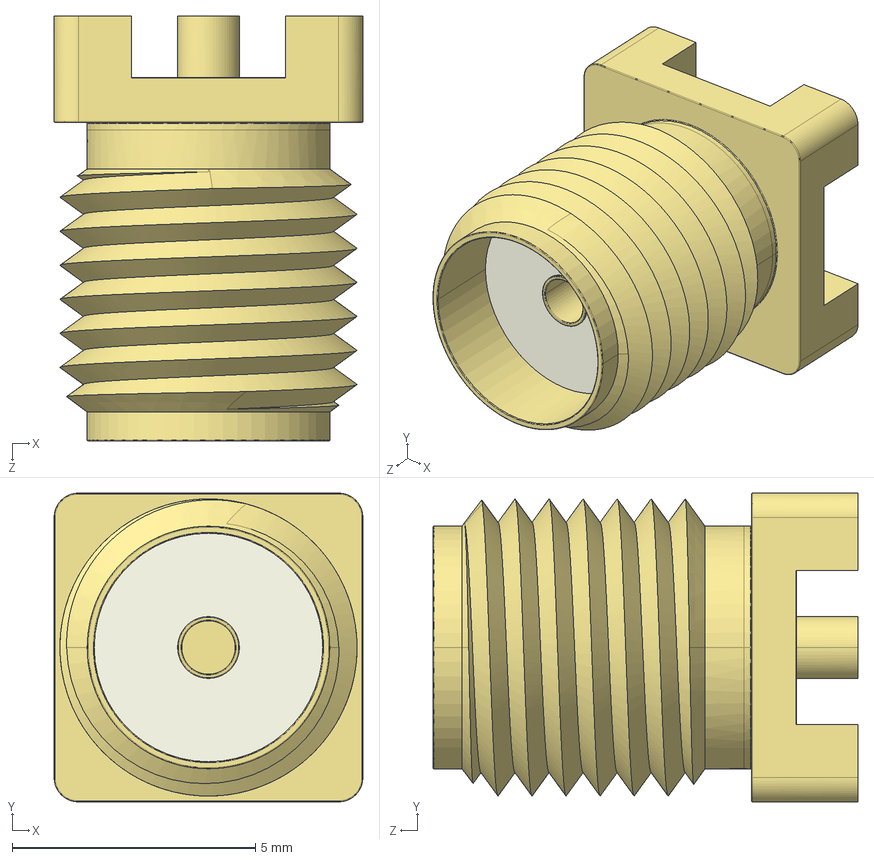
[picture p61: CAD file, 2021-04-16]
3D/User Library-SMA_132134_Corrected.STEP
6.35 x 6.35 x 8.74 mm
SMA_132134_Body
SMA_132134_Plastic
