dbaudin1/Kicad_Libraries_Perso/3D/DF12NB(5.0)-20DP.stp

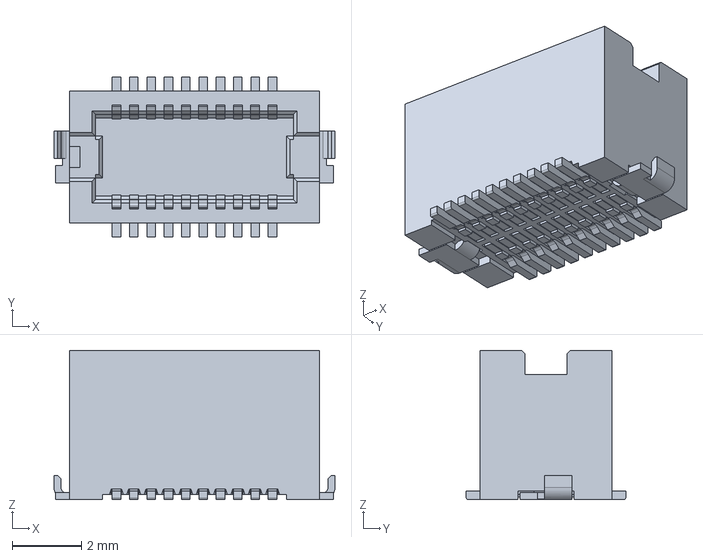
[picture p62: CAD file, 2021-04-16]
3D/DF12NB(5.0)-20DP.stp
8.10 x 4.60 x 4.30 mm
