dbaudin1/Kicad_Libraries_Perso/3D/SMA_RA.stp

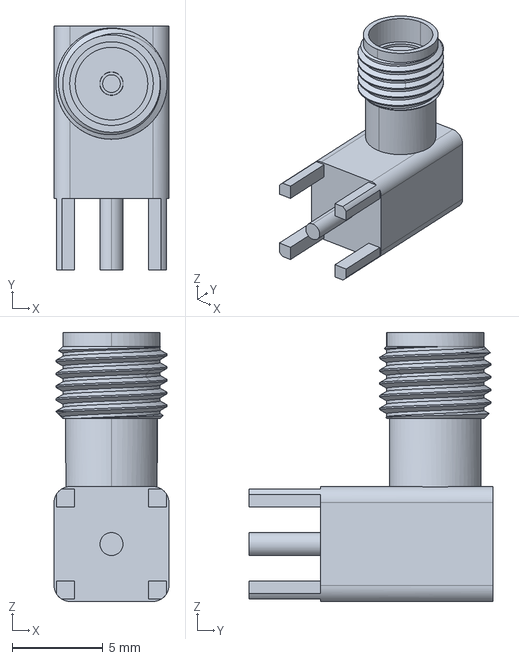
[picture p63: CAD file, 2021-04-16]
3D/SMA_RA.stp
6.35 x 13.5 x 14.9 mm
