dbaudin1/Kicad_Libraries_Perso/(list of files, cad)

Other CAD files:
3D/IDEFXS.FCStd
3D/FX10A-140S14-SV.stp
3D/FX10A-168P-SV.stp
3D/09041102020300_100072375MOD000B.stp
3D/09042101020450_100072387MOD000B.stp
3D/1017503.step
3D/1050570001.stp
3D/73251-0132.stp
3D/744272222 (rev1).stp
3D/DIN41612_02x16_RA.stp
3D/JS202011JCQN--3DModel-STEP-1.STEP
3D/OS102011MS2QN1C.stp
3D/SM102032007FE.step
