dbaudin1/Kicad_Libraries_Perso/(notices)

Notices in the files:
3D/CLP-109-02-F-DH.stp:
author */ ('License CC BY-ND 4.0'),
